austinc3030/openpilot_on_mk6_golf/CAN Gateway Swap/Screen Shot 2019-11-27 at 14.14.55.png

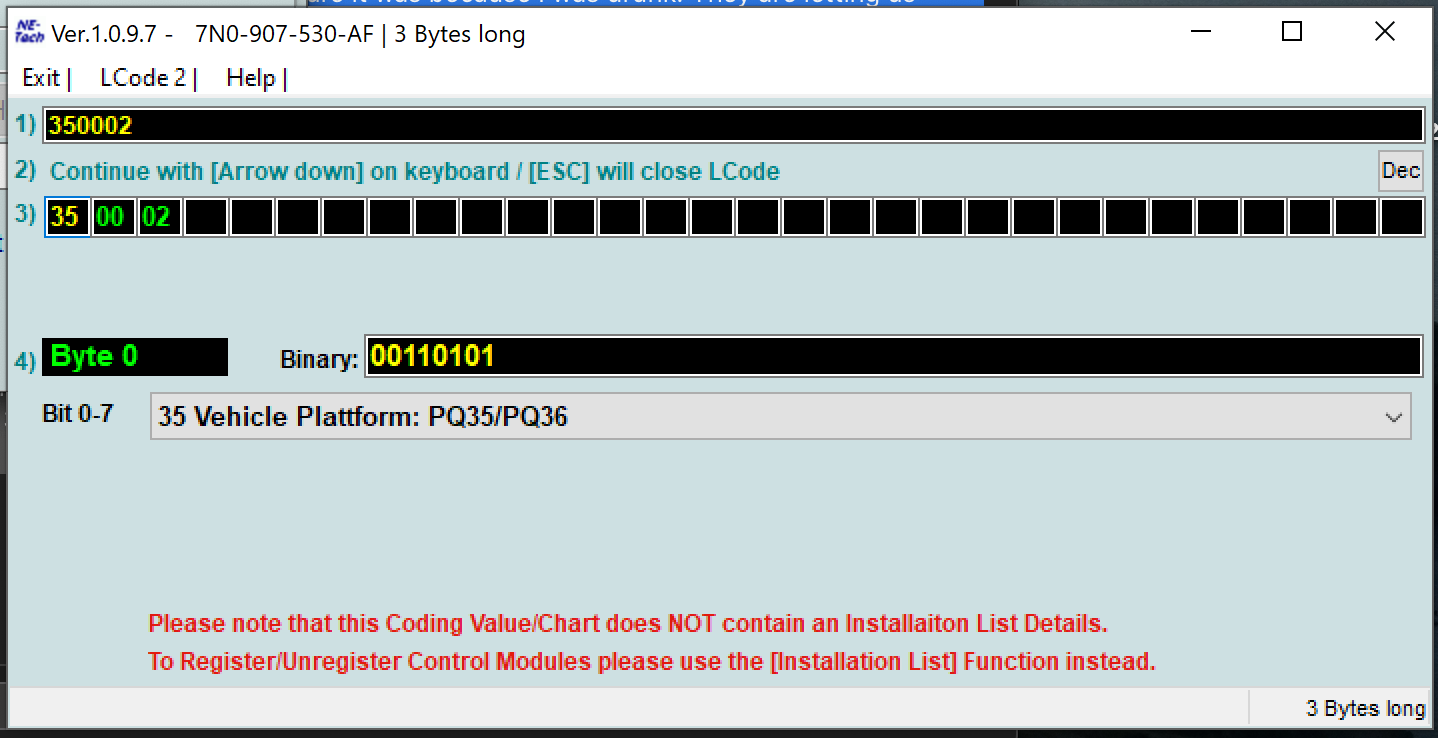
CAN Gateway Swap/Screen Shot 2019-11-27 at 14.14.55.png
