austinc3030/openpilot_on_mk6_golf/CAN Gateway Swap/Screen Shot 2019-11-27 at 14.20.48.png

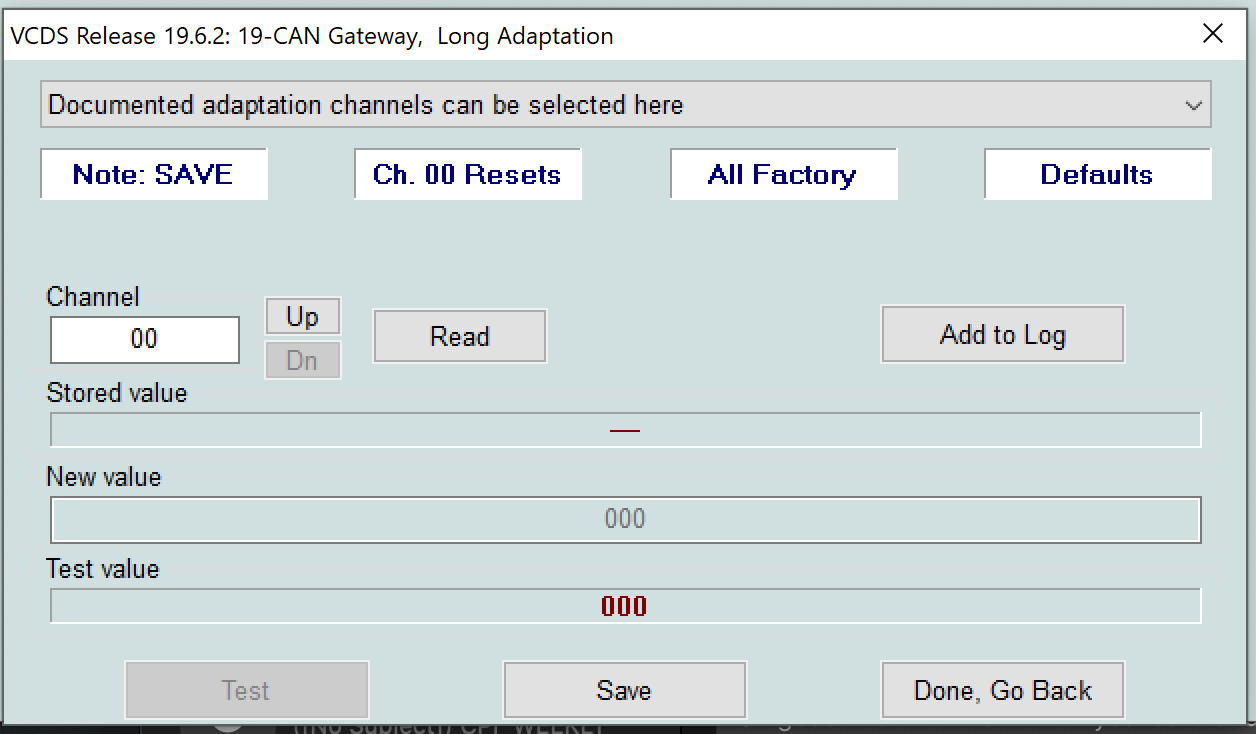
CAN Gateway Swap/Screen Shot 2019-11-27 at 14.20.48.png
