austinc3030/openpilot_on_mk6_golf/CAN Gateway Swap/Screen Shot 2019-11-27 at 14.29.13.png

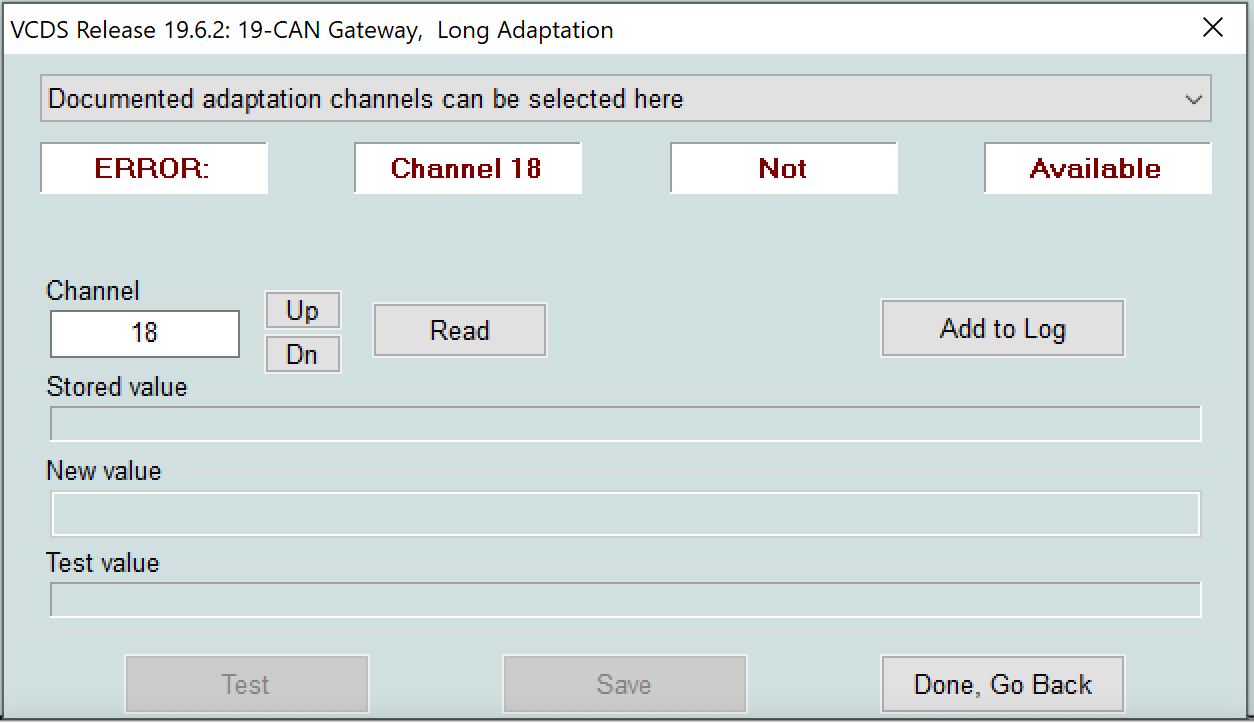
CAN Gateway Swap/Screen Shot 2019-11-27 at 14.29.13.png
