austinc3030/openpilot_on_mk6_golf/Open Pilot Parts Cost.xlsx

Sheet: @Edgy
Conversion Rate | 1.135
Item | Part Number | Quantity | EUR |  |  | Conversion | USD |  |  | Amount Paid
 |  |  | Unit Cost | Shipping | Line Total |  | Unit Cost | Shipping | Line Total | Date | Amount(EUR) | Amount(USD)
Steering Column Under Fairing | 5N0 858 566 D | 1 | €19.20 | €13.71 | €32.91 | 1.135 | $21.79 | $15.56 | $37.35 | 2019-11-04 | €977.55 | $1199.99
Stalk | 1K0 953 513 H | 1 | €74.96 | €7.50 | €82.46 | 1.135 | $85.08 | $8.51 | $93.59 | 2019-11-06 | €215.98 | $254.98
LKAS Camera | 3AA 980 654 D | 1 | €76.69 | €25.56 | €102.25 | 1.135 | $87.04 | $29.01 | $116.05 | 2019-11-06 | €70.00 | $85.08
Steering Module Controller | 1K0 953 549 CD | 1 | €49.90 | €18.90 | €68.80 | 1.135 | $56.64 | $21.45 | $78.09 | 2019-11-07 | €50.00 | $62.59
Radar | 3AA 907 567 A | 1 | €399.95 | €12.00 | €411.95 | 1.135 | $453.94 | $13.62 | $467.56
LKAS Camera Mount | 5K0 857 511 B | 1 | €125.00 | €9.99 | €134.99 | 1.135 | $141.88 | $11.34 | $153.21
ACC Harness |  | 1 | €30.89 | €2.44 | €33.33 | 1.135 | $35.06 | $2.77 | $37.83
LKAS Harness |  | 1 | €22.63 | €2.44 | €25.07 | 1.135 | $25.69 | $2.77 | $28.45
Compass | 5N0 919 879 | 1 | €60.99 | €1.24 | €62.23 | 1.135 | $69.22 | $1.41 | $70.63
USB Connector | 5KD 035 726 A | 1 | €17.42 | €1.24 | €18.66 | 1.135 | $19.77 | $1.41 | $21.18
Auto Headlight Rain Sensor |  | 1 | €60.99 | €1.24 | €62.23 | 1.135 | $69.22 | $1.41 | $70.63
CAN Wire |  | 1 | €15.00 | €1.24 | €16.24 | 1.135 | $17.02 | $1.41 | $18.43
Shipping to USA |  |  |  | €137.00 | €137.00 | 1.135 | $0.00 | $155.50 | $155.50
Grand Total |  |  |  |  | €1188.12 |  |  |  | $1348.52 |  | €1313.53 | $1602.64

Sheet: Parts List and Cost
Item | Part Number | Quantity | Unit Cost | Shipping | Line Total | Purchased | Received
Steering Column Under Fairing | 5N0 858 566 D | 1 | $21.79 | $15.56 | $37.35 | X
Stalk | 1K0 953 513 H | 1 | $85.08 | $8.51 | $93.59 | X
LKAS Camera | 3AA 980 654 D | 1 | $87.04 | $29.01 | $116.05 | X
Steering Module Controller | 1K0 953 549 CD | 1 | $56.64 | $21.45 | $78.09 | X
Radar | 3AA 907 567 A | 1 | $453.94 | $13.62 | $467.56 | X
LKAS Camera Mount | 5K0 857 511 B | 1 | $141.88 | $11.34 | $153.21 | X
ACC Harness |  | 1 | $35.06 | $2.77 | $37.83 | X
LKAS Harness |  | 1 | $25.69 | $2.77 | $28.45 | X
CAN Wire |  | 1 | $17.02 | $1.41 | $18.43 | X
Panda |  | 1 | $99.00 | $0.00 | $99.00 | X | X
Extended CAN Gateway | 7N0 907 530 AJ | 1 | $24.58 | $5.51 | $30.09 | X
Aluminum Plate |  | 1 | $21.24 | $0.00 | $21.24 | X
Sniffer Cable |  | 1 | $68.00 | $0.00 | $68.00 | X
EON |  | 1 | $599.00 | $0.00 | $599.00
VW Emblem | 3D0-853-601-F-JZA | 1 | $148.50 | $8.87 | $157.37 | X
For @Edgy's Help |  | 1 | $254.12 | $0.00 | $254.12
Shipping to USA |  | 1 | $0.00 | $155.50 | $155.50
Grand Total |  |  |  |  | $2414.89
