austinc3030/openpilot_on_mk6_golf/Radar Mount/Radar Mount.stl

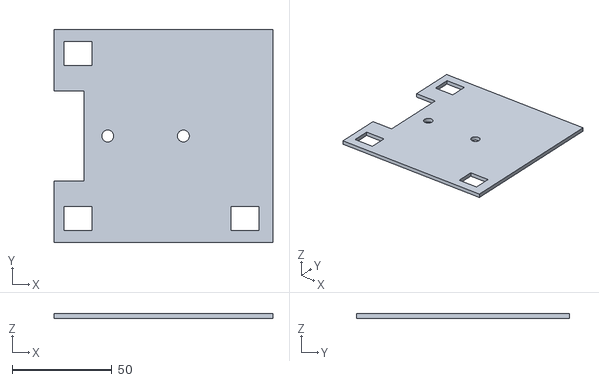
[picture p23: CAD file, 2019-11-24]
Radar Mount/Radar Mount.stl
110.0 x 107.0 x 2.50
