austinc3030/openpilot_on_mk6_golf/(list of files, cad)

Other CAD files:
Radar Mount/Radar Mount.skp
Radar Mount/Radar Mount~.skp
