austinc3030/openpilot_on_mk6_golf/Guide/OpenPilot on MK6 Golf Project Log_R1.docx

# Reference PDF

1. https://www.dropbox.com/s/1v9gxusxpqdxpxt/umruestung-acc-final.pdf?dl=0
  a. Translated version is below (Unsure of accuracy)

# Translated Reference PDF

ACC / FRONT ASSIST RETROFITTING GOLF VI GTI MY 2011 [B]

Hints for conversion:

1. The GRA lever part number 3C9 953 501 BM must be disassembled and installed / replaced in the GRA lever part number 5K0 953 501 CS. It should be noted that all levers are the ATW company, otherwise compatibility is not guaranteed.
2. The cladding of the steering column, of course, no longer fits with the Golf's because of the third lever. Therefore, the lower fairing with part number 5N0 858 566D is required. The upper panel is identical and can still be used. However, this disguise is probably only in the sentence.
3. The steering column control unit from a Passat B7 would fit, also has the required ignition connector, but this is no longer wired to board according to several statements (SMD fuse). Although this can be retrofitted and thus a control unit from a Passat would be suitable. However, this can be circumvented by using the SMLS controller part number 5K0 953 569 AL from a Tiguan / Sharan. Background to this is the following. The Passat has no more ignition connector as in the Golf VI but it runs a lot on CAN or external/extra wires. Since the Golf VI does not have this of course the ZAS plug must work.
4. Conversion ZAS plug. The ZAS connector on the SMLS of the Golf VI has 8 pins. However, the new 5K0 953 569 AL can only accept 6 pins. The plug must be rewired using the overview on the next pages.
5. For the radar there is an adapter cable with the number 1J0 973 715. The line is the 10-pin connector for the radar available and about 1m line. Of course, that's not enough for the interior of the vehicle. Therefore, this line must be extended. Wiring diagram see below.
6. After everything has been connected and installed it goes to the coding ...
7. Of course, an extended gateway is required.
8. Regarding VW emblem and attachment. The VW emblem from the Passat B7 fits freely. So only needs to be replaced. A bracket has been custom made and can be bolted to the front.

Thanks again to the two users [VCP-Forum] "bluemevo" and "jmb123". Without the guys it would not have gone that way :) THANK YOU !!!

Components Used:

- Panel 5N0 858 566D below / 5N0 858 565 B above
- Steering column switch (3 lever) from Tiguan, Sharan ... 5K0 953 501 CS (ATW)
- Steering column switch (3 lever) from Passat, 3C9 953 501 BM (steering lever 3C9 953 502 E) (ATW)
- Control unit 5K0 953 569 AL
- Ignition Lock Plug 5K0 905 865 (6-pin)
- Adapter cable Radar with connector 1J0 973 715 (10pin)
- Mounting plate 5K0 953 223 (ATW)
- B7 Radar 3AA 907 567 A HW036/SW0170
- VW Emblem 3D0 853 601 F JZA Passat B7 [3C0 853 601 A Passat B6]

Pin assignment of radar camera with vehicle: [3AA 907 567 A]

Radar | Aim
10 | Plus / Ignition SC4
9/2 | Mass
5 LOW | 7 Gateway
4 HIGH | 17 Gateway
8 | T16 / 5 steering column (16pol)

# checked 23.10.2016 i.O

Pin assignment SMLS control unit: [5K0 953 569 AL]

Ignition lock [Black] | SMLS 8 pin [ALT white] | SMLS 6pin [NEW white]
1 | 1 | 5
2 | 3 | 6
3 | 4 | 4
4 (Free)
5 (Free)
6 | 5 | 3
* DSG Key Trigger Lock | SMLS 8 pin [ALT white] | SMLS 6pin [NEW white]
2 [rt+] | 7 | 2 [rot]
1 [bl-] | 8 | 1 [blue]

* not applicable to vehicles with manual transmission

# tested 27.10.2016 i.O

Coding:

Address 01: Engine electronics (CCZ) Label file: 06J-907-115-CCZ.clb

Part number SW: 5K0 907 115 HW: 1K0 907 115 AA

Component: 2.0l R4 / 4V TFSI 0050

Revision: AAH18 --- Serial Number:

Coding: 0403000C1C070260

* Coding byte 5; Bit 1 to 0; Bit 2 to 1 (ACC)

Address 03: Brake electronics (J104) Label file: DRV \ 1K0-907-379-60EC1F.clb

Part Number SW: 1K0 907 379 BJ HW: 1K0 907 379 BJ

Component: ESP MK60EC1 H31 0121

Revision: 00H31001

Coding: 143B600D092B00FF281006E7901C0041150C00

* Coding byte 16; Bit 5 to 0

Address 16: Steering wheel electronics (J527) Label file: DRV \ 5K0-953-569.clb

Part number SW: 5K0 953 501 CS HW: 5K0 953 569 AL

Component: STEERING MODULE 016 0140

Revision: FF010042 Serial number: 20131220300868

Coding: 389AA40000

* Coding byte 2; Bit 7 to 1; Bit 4 to 1

Address 13: Distance control Label file: DRV \ 3AA-907-567.clb

Part Number SW: 3AA 907 567 A HW: 3AA 907 567

Component: AC201 RDW A 036 0170

Revision: 00036000 Serial Number: 00000000902524

Coding: 0010000

* Coding 0010000 (DSG)

Adaptation channels:

Brakes deactivated to standstill (only works with newer ABS control units)

Electronic parking brake disabled

Procedure Coding: [Login: 201] Activation of the adaptation channels; Unlock in APK2

with login code, coding and locking again.

Address 19: Diagnostic Interface (J533) Label file: DRV \ 7N0-907-530-V2.clb

Part Number SW: 7N0 907 530 AA HW: 7N0 907 530 G

Component: J533 Gateway H41 1632

Revision: H41 serial number: 080412F6000270

Coding: 350002

* Add list to address 13.

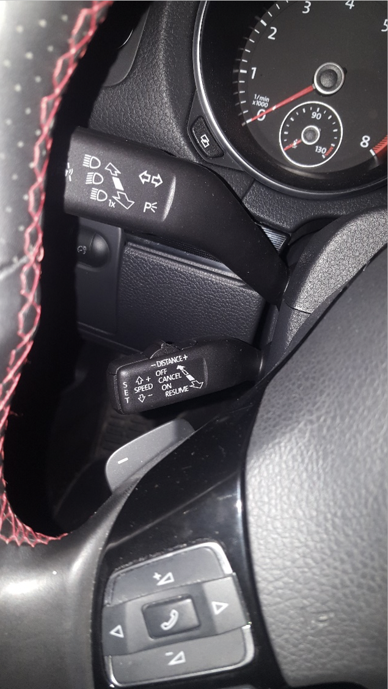
[picture p24: figure]
page4image65334656
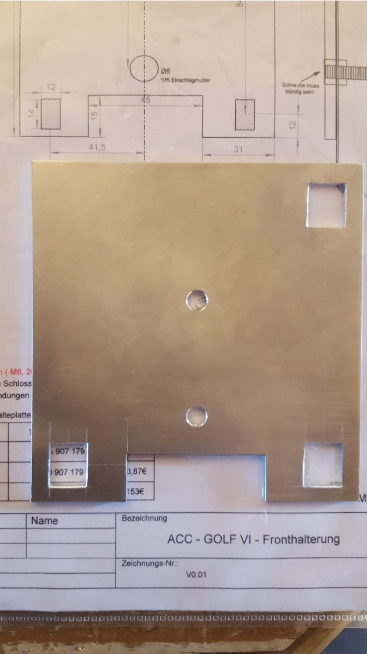
[picture p25: figure]
page4image65332992
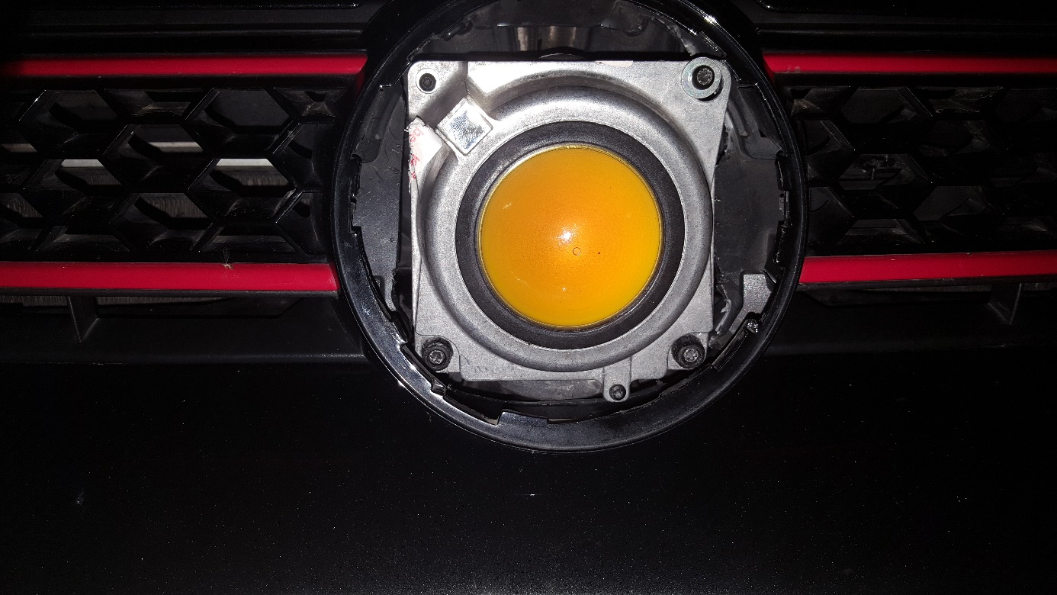
[picture p26: figure]
page4image65335904
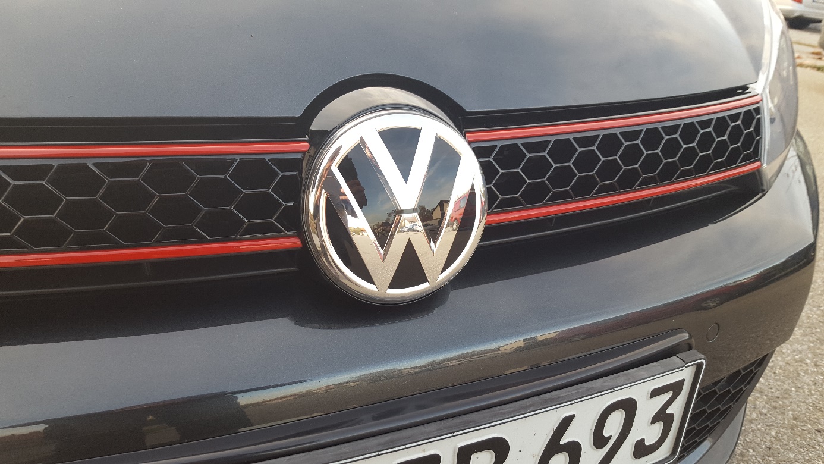
[picture p27: figure]
page5image65307456
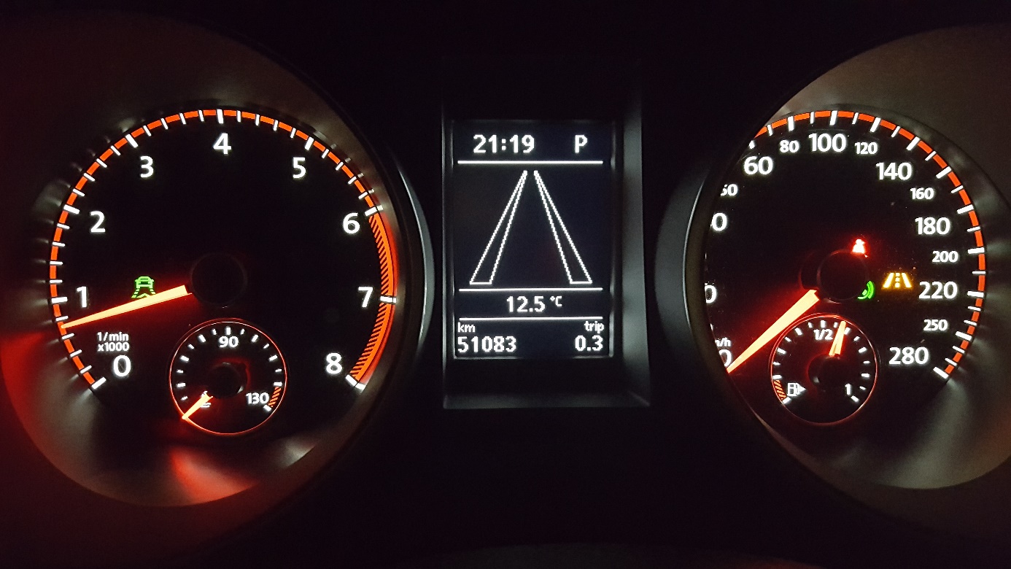
[picture p28: figure]
page5image65310784

!!Caution!! It is a complex retrofit that a layman does not do

should. In particular, it must be mentioned that the airbag must be dismantled. That's why I give no guarantee of completeness and correctness. I have everything documented and best knowledge. For me it worked! There is only a small handful of vehicles for the conversion. Therefore, that said, it's not a universal guide for anyone. I also had a lot of support.

V2.0 Final

11/4/16

**Most information from here on was derived from the above document

# Testing if ECU Supports ACC

1. Open 01-Engine Module
2. Open Security Access – 16, Enter 12233 for Security Access
3. In Coding II – 11, Enter the following codes
  a. 16167 – Deactivate Cruise Control
  b. 13377 – Activate ACC
  c. 30903 – Activate ACC follow to stop (Requires EPB)
4. Open 03-ABS Module
5. Open Coding – 07
6. Open Long Coding Helper
  a. Change byte 16, set bit 5 from 1 to 0
    i. Need to change binary from 10110111 to 10010111
7. To disable ACC (and turn off CEL that flashes), revert the binary change in step 6, and re-enter the codes from step 3. Note: standard cruise control will not work after this. Still waiting on potential code to re-enable CC.

# Parts Needed

1. Need
  a. New Gateway
  b. New Stalk
  c. Multi-Function Steering Wheel
  d. Radar if we want better ACC
    i. Radar will need custom mount
      1. See PDF for dimensions and possible part number
      2. 3d Printable Model: https://www.thingiverse.com/thing:3954928
  e. J533 Sniffer Cable
    i. Can order from @jyoung8607 on Discord ($68 in USA, $36.70 for Other Countries)
    ii. Could also build one per https://community.comma.ai/wiki/index.php/J533_Sniffing_Cable
  f. Panda
    i. https://community.comma.ai/wiki/index.php/Panda
    ii. $99 Free Shipping to US (Maybe other countries?)
  g. EON Device Kit
    i. https://comma.ai/shop/products/eon-gold-dashcam-devkit
      1. Select Development Vehicle for Vehicle Harness

# Possible Part Numbers and Prices

1. From Discord
  a. Golf MK6 Stalk
    i. Mentioned by @Edgy
    ii. 1K0 953 513 H
2. From German PDF
  a. Lower Fairing
    i. 5K0 858 566 D
  b. Upper Fairing
    i. 5K0 858 565 B
  c. Tiguan/Sharan Steering Column Switch
    i. 5K0 953 501 CS
  d. Passat Steering Column Switch
    i. 3C9 953 501 BM
      1. Steering Lever Only
        a. 3C9 953 502 E
  e. Control Unit
    i. 5K0 953 569 AL
  f. Ignition Switch
    i. 5K0 905 865
      1. 6-pin
  g. Radar Adapter Cable with Connector
    i. 1J0 973 715
      1. 10-pin
  h. Stalk Mounting Plate
    i. Made By ATW
    ii. 5K0 953 223
      1. https://www.ecstuning.com/b-genuine-volkswagen-audi-parts/plate/5k0953223/ ($21.69)
  i. Radar
    i. 3AA 907 567 A HW036 / SW0170
      1. From Passat B7
  j. Radar Transparent VW Emblem
    i. 3D0 853 601F JZA
      1. From Passat B7
      2. https://www.vwdiscountparts.com/Volkswagen-CC-Emblem-p/3d0-853-601-f-jza-62650.htm ($148.50)
    ii. 3C0 853 601 A
      1. From Passat B6
      2. https://www.vwdiscountparts.com/Volkswagen-Passat-Emblem-p/3c0-853-601-a-jza-57148.htm ($94.50)

1 Written by @austinc3030 with support from Comma AI’s Discord channel

MK6 OpenPilot Project Log and Information
